akutta/URCA-Mayer-Robotic-Arm/Hexapod Research/Paper/LegSegment_NoHousing_CutawaySide.png

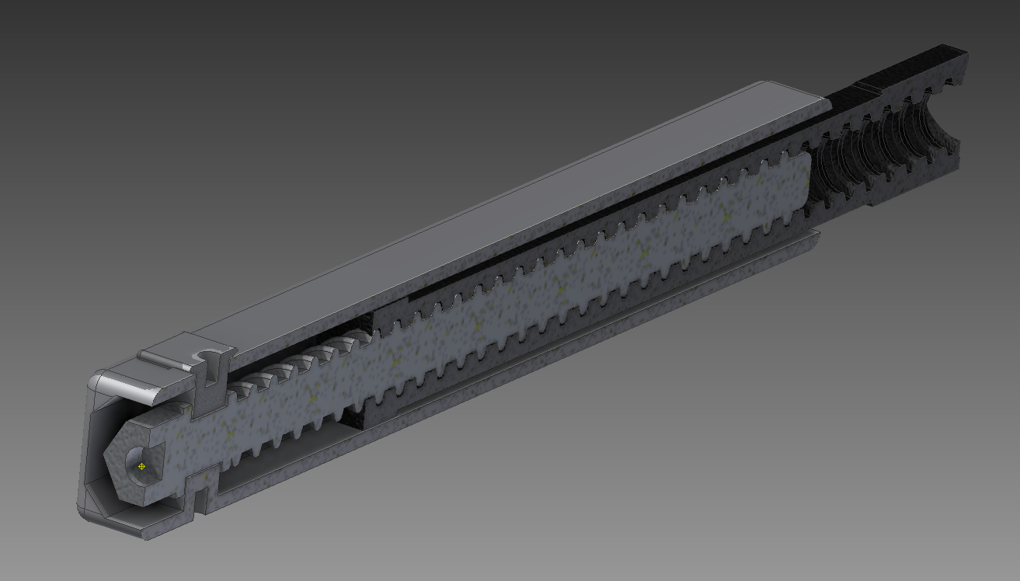
Hexapod Research/Paper/LegSegment_NoHousing_CutawaySide.png
