akutta/URCA-Mayer-Robotic-Arm/Hexapod Research/Paper/Gearbox_InputVisible.png

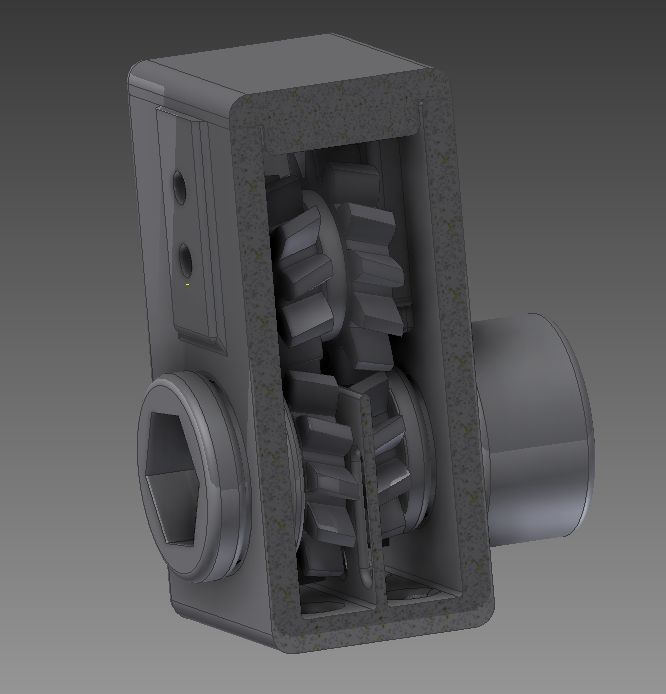
Hexapod Research/Paper/Gearbox_InputVisible.png
