akutta/URCA-Mayer-Robotic-Arm/Hexapod Research/Paper/Gearbox_OutputVisible.png

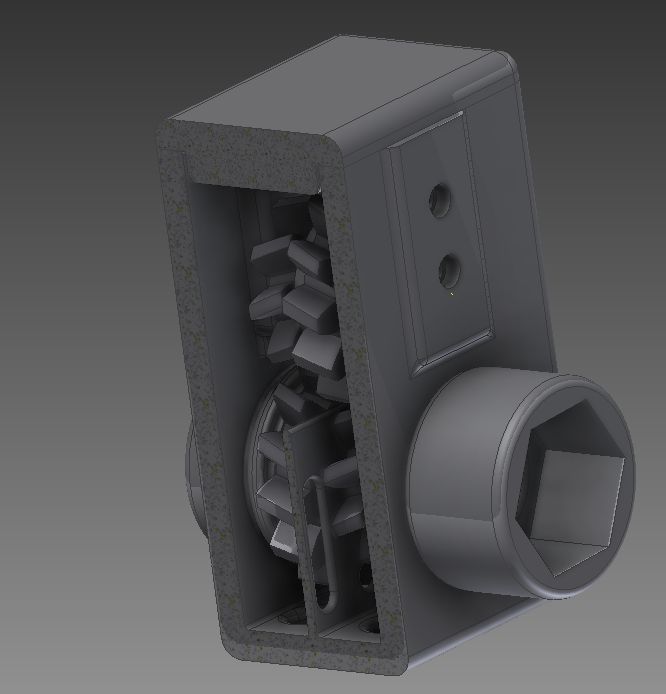
Hexapod Research/Paper/Gearbox_OutputVisible.png
