akutta/URCA-Mayer-Robotic-Arm/Hexapod Research/Leg Design/tooth sketch.dxf

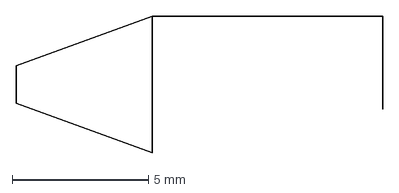
[picture p8: CAD file, 2011-12-19]
Hexapod Research/Leg Design/tooth sketch.dxf
13.5 x 5.00 mm
