akutta/URCA-Mayer-Robotic-Arm/Hexapod Research/Leg Design/ToPrint/GearBox_ProperConstraints.stl

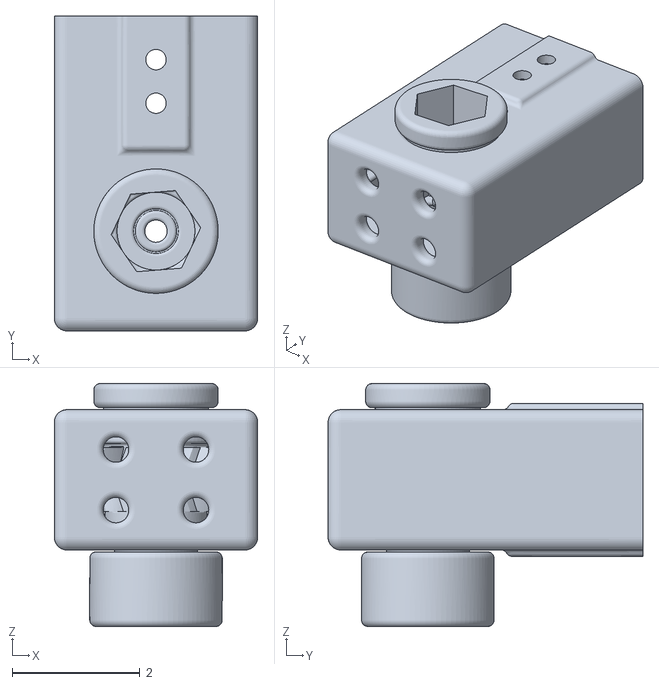
[picture p9: CAD file, 2011-12-19]
Hexapod Research/Leg Design/ToPrint/GearBox_ProperConstraints.stl
3.19 x 4.94 x 3.81
