akutta/URCA-Mayer-Robotic-Arm/Hexapod Research/Leg Design/ToPrint/GearBoxTop.stl

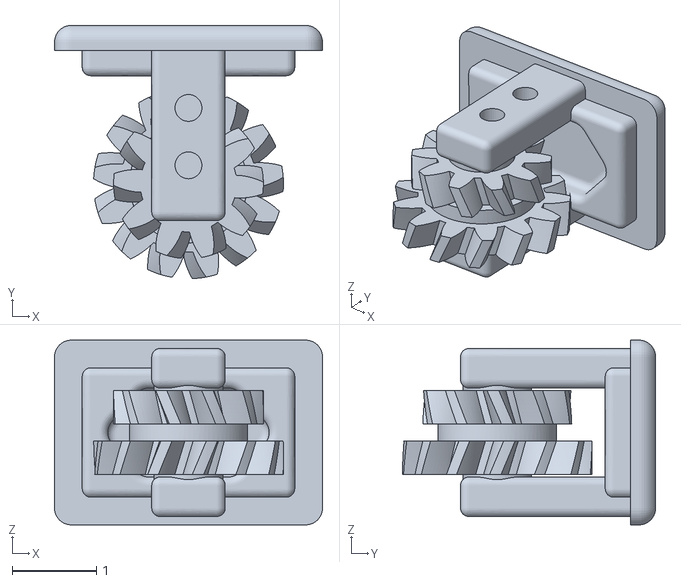
[picture p10: CAD file, 2011-12-19]
Hexapod Research/Leg Design/ToPrint/GearBoxTop.stl
3.19 x 3.02 x 2.20
