akutta/URCA-Mayer-Robotic-Arm/Hexapod Research/Leg Design/ToPrint/GearBox_Pin.stl

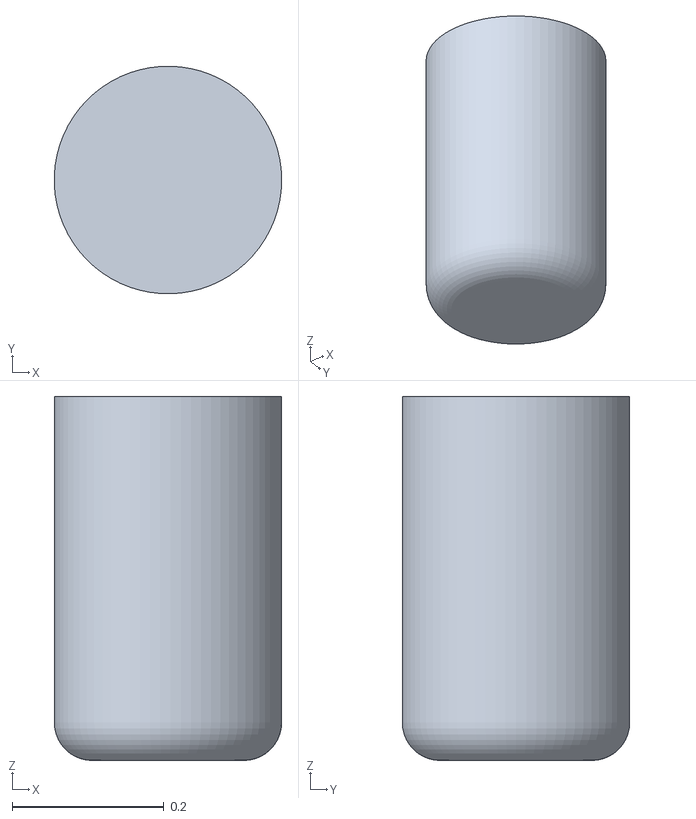
[picture p11: CAD file, 2011-12-19]
Hexapod Research/Leg Design/ToPrint/GearBox_Pin.stl
0.3 x 0.3 x 0.48
