akutta/URCA-Mayer-Robotic-Arm/(list of files, cad)

Other CAD files:
Hexapod Research/Leg Design/ExtendingArm.iam
Hexapod Research/Leg Design/ExtendingArm_Adaptive.iam
Hexapod Research/Leg Design/ExtendingArm_ProperConstraints.iam
Hexapod Research/Leg Design/InternalKey.ipt
Hexapod Research/Leg Design/LowerArm.ipt
Hexapod Research/Leg Design/OldVersions/ExtendingArm_Adaptive.0001.iam
Hexapod Research/Leg Design/OldVersions/ExtendingArm_Adaptive.0002.iam
Hexapod Research/Leg Design/OldVersions/ExtendingArm_ProperConstraints.0110.iam
Hexapod Research/Leg Design/OldVersions/InternalKey.0015.ipt
Hexapod Research/Leg Design/OldVersions/InternalKey.0016.ipt
Hexapod Research/Leg Design/OldVersions/LowerArm.0024.ipt
Hexapod Research/Leg Design/OldVersions/Screw.0028.ipt
Hexapod Research/Leg Design/OldVersions/ServoToScrewKey.0014.ipt
Hexapod Research/Leg Design/OldVersions/TwoLegSegemnt_Adaptive.0006.iam
Hexapod Research/Leg Design/OldVersions/UpperRobotArm.0023.ipt
Hexapod Research/Leg Design/Other Parts/ArmPivot.ipt
Hexapod Research/Leg Design/Other Parts/GearLargeAndSmall.ipt
Hexapod Research/Leg Design/Other Parts/GearToScrewMerged.ipt
Hexapod Research/Leg Design/Other Parts/Intermediary Gear Box/Assemblies/BlankGearLargeAndSmall.ipt
Hexapod Research/Leg Design/Other Parts/Intermediary Gear Box/Assemblies/BlankLargeGearMotorInput.ipt
Hexapod Research/Leg Design/Other Parts/Intermediary Gear Box/Assemblies/BlankSmallGearOutput.ipt
Hexapod Research/Leg Design/Other Parts/Intermediary Gear Box/Assemblies/LargeGearInput.iam
Hexapod Research/Leg Design/Other Parts/Intermediary Gear Box/Assemblies/LargeSmallTransferGear.iam
Hexapod Research/Leg Design/Other Parts/Intermediary Gear Box/Assemblies/OldVersions/BlankGearLargeAndSmall.0007.ipt
Hexapod Research/Leg Design/Other Parts/Intermediary Gear Box/Assemblies/OldVersions/BlankLargeGearMotorInput.0005.ipt
Hexapod Research/Leg Design/Other Parts/Intermediary Gear Box/Assemblies/OldVersions/BlankSmallGearOutput.0010.ipt
Hexapod Research/Leg Design/Other Parts/Intermediary Gear Box/Assemblies/OldVersions/LargeGearInput.0002.iam
Hexapod Research/Leg Design/Other Parts/Intermediary Gear Box/Assemblies/OldVersions/LargeSmallTransferGear.0003.iam
Hexapod Research/Leg Design/Other Parts/Intermediary Gear Box/Assemblies/OldVersions/SmallOutputGear.0004.iam
Hexapod Research/Leg Design/Other Parts/Intermediary Gear Box/Assemblies/SmallOutputGear.iam
Hexapod Research/Leg Design/Other Parts/Intermediary Gear Box/Assemblies/TopAndIntermediaryAxle.iam
Hexapod Research/Leg Design/Other Parts/Intermediary Gear Box/DerivedPartsFromAssemblies/GearboxTopAndAxle.ipt
Hexapod Research/Leg Design/Other Parts/Intermediary Gear Box/DerivedPartsFromAssemblies/LargeGearInput.ipt
Hexapod Research/Leg Design/Other Parts/Intermediary Gear Box/DerivedPartsFromAssemblies/OldVersions/GearboxTopAndAxle.0014.ipt
Hexapod Research/Leg Design/Other Parts/Intermediary Gear Box/DerivedPartsFromAssemblies/OldVersions/LargeGearInput.0019.ipt
Hexapod Research/Leg Design/Other Parts/Intermediary Gear Box/DerivedPartsFromAssemblies/OldVersions/SmallGearOutput.0015.ipt
Hexapod Research/Leg Design/Other Parts/Intermediary Gear Box/DerivedPartsFromAssemblies/OldVersions/TransferGear.0006.ipt
Hexapod Research/Leg Design/Other Parts/Intermediary Gear Box/DerivedPartsFromAssemblies/SmallGearOutput.ipt
Hexapod Research/Leg Design/Other Parts/Intermediary Gear Box/DerivedPartsFromAssemblies/TransferGear (Andrew Kutta's conflicted copy 2011-10-31).ipt
Hexapod Research/Leg Design/Other Parts/Intermediary Gear Box/DerivedPartsFromAssemblies/TransferGear.ipt
Hexapod Research/Leg Design/Other Parts/Intermediary Gear Box/Gear2_LargeAndSmall.iam
Hexapod Research/Leg Design/Other Parts/Intermediary Gear Box/GearBox.iam
Hexapod Research/Leg Design/Other Parts/Intermediary Gear Box/GearBox/Design Accelerator/Spur Gear11.ipt
Hexapod Research/Leg Design/Other Parts/Intermediary Gear Box/GearBox/Design Accelerator/Spur Gear21.ipt
Hexapod Research/Leg Design/Other Parts/Intermediary Gear Box/GearBox/Design Accelerator/Spur Gears1.iam
Hexapod Research/Leg Design/Other Parts/Intermediary Gear Box/GearBoxPin.ipt
Hexapod Research/Leg Design/Other Parts/Intermediary Gear Box/GearBoxTop.ipt
Hexapod Research/Leg Design/Other Parts/Intermediary Gear Box/GearBox_ProperConstraints (Andrew Kutta's conflicted copy 2011-10-31).iam
Hexapod Research/Leg Design/Other Parts/Intermediary Gear Box/GearBox_ProperConstraints.iam
Hexapod Research/Leg Design/Other Parts/Intermediary Gear Box/GearboxWallOutput.ipt
Hexapod Research/Leg Design/Other Parts/Intermediary Gear Box/LargeSmallGearAxis.ipt
Hexapod Research/Leg Design/Other Parts/Intermediary Gear Box/OldVersions/BlankGearLargeAndSmall.0005.ipt
Hexapod Research/Leg Design/Other Parts/Intermediary Gear Box/OldVersions/BlankGearbox.0002.iam
Hexapod Research/Leg Design/Other Parts/Intermediary Gear Box/OldVersions/BlankLargeGearMotorInput.0008.ipt
Hexapod Research/Leg Design/Other Parts/Intermediary Gear Box/OldVersions/BlankSmallGearOutput.0005.ipt
Hexapod Research/Leg Design/Other Parts/Intermediary Gear Box/OldVersions/Gear2_LargeAndSmall.0002.iam
Hexapod Research/Leg Design/Other Parts/Intermediary Gear Box/OldVersions/GearBox.0026.iam
Hexapod Research/Leg Design/Other Parts/Intermediary Gear Box/OldVersions/GearBoxPin.0004.ipt
Hexapod Research/Leg Design/Other Parts/Intermediary Gear Box/OldVersions/GearBoxTop.0006.ipt
Hexapod Research/Leg Design/Other Parts/Intermediary Gear Box/OldVersions/GearBox_ProperConstraints.0086.iam
Hexapod Research/Leg Design/Other Parts/Intermediary Gear Box/OldVersions/GearboxWallOutput.0045.ipt
Hexapod Research/Leg Design/Other Parts/Intermediary Gear Box/OldVersions/InputGear.0001.ipt
Hexapod Research/Leg Design/Other Parts/Intermediary Gear Box/OldVersions/LargeGear.0004.ipt
Hexapod Research/Leg Design/Other Parts/Intermediary Gear Box/OldVersions/LargeGearMotorInput.0010.ipt
Hexapod Research/Leg Design/Other Parts/Intermediary Gear Box/OldVersions/LargeGearMotorInput.0011.ipt
Hexapod Research/Leg Design/Other Parts/Intermediary Gear Box/OldVersions/LargeSmallGearAxis.0006.ipt
Hexapod Research/Leg Design/Other Parts/Intermediary Gear Box/OldVersions/SmallGear.0004.ipt
Hexapod Research/Leg Design/Other Parts/Intermediary Gear Box/OldVersions/SmallGearOutput.0009.ipt
Hexapod Research/Leg Design/Other Parts/Intermediary Gear Box/gear.iam
Hexapod Research/Leg Design/Other Parts/Intermediary Gear Box/gear/Design Accelerator/OldVersions/Spur Gear11.0002.ipt
Hexapod Research/Leg Design/Other Parts/Intermediary Gear Box/gear/Design Accelerator/OldVersions/Spur Gear21.0003.ipt
Hexapod Research/Leg Design/Other Parts/Intermediary Gear Box/gear/Design Accelerator/OldVersions/Spur Gears1.0002.iam
Hexapod Research/Leg Design/Other Parts/Intermediary Gear Box/gear/Design Accelerator/Spur Gear11.ipt
Hexapod Research/Leg Design/Other Parts/Intermediary Gear Box/gear/Design Accelerator/Spur Gear21.ipt
Hexapod Research/Leg Design/Other Parts/Intermediary Gear Box/gear/Design Accelerator/Spur Gears1.iam
Hexapod Research/Leg Design/Other Parts/Intermediary Gear Box/gear1.ipt
Hexapod Research/Leg Design/Other Parts/Intermediary Gear Box/gear2.ipt
Hexapod Research/Leg Design/Other Parts/Motor Housing/MotorHousingBottom.ipt
Hexapod Research/Leg Design/Other Parts/Motor Housing/MotorHousingBottom_split1.ipt
Hexapod Research/Leg Design/Other Parts/Motor Housing/MotorHousingBottom_split2.ipt
Hexapod Research/Leg Design/Other Parts/Motor Housing/MotorHousingBottom_split3.ipt
Hexapod Research/Leg Design/Other Parts/Motor Housing/MotorHousingGearboxTop.ipt
Hexapod Research/Leg Design/Other Parts/Motor Housing/MotorHousingTopMotorSupport.ipt
Hexapod Research/Leg Design/Other Parts/Motor Housing/OldVersions/MotorHousingBottom.0045.ipt
Hexapod Research/Leg Design/Other Parts/Motor Housing/OldVersions/MotorHousingBottom_split1.0003.ipt
Hexapod Research/Leg Design/Other Parts/Motor Housing/OldVersions/MotorHousingBottom_split2.0007.ipt
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
